jps2000/Horselite/README.md

# Horselite
3D printed spirometer for horses to be used with Datex Capnomac
For scientific purposes only.
