jps2000/Horselite/HorseLite 3D.pdf

### Horse_

©Vetme

Abstract

The sens
sensor. T
for horse

Pictures

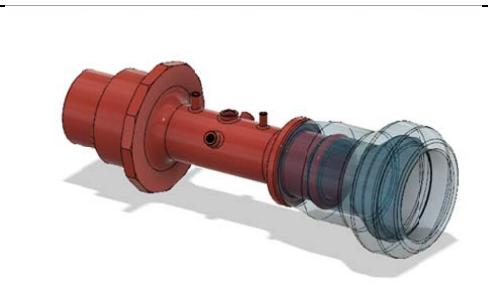
[picture p1: figure]

Descript

T
w

Referenc

MOENS
Proceed

MOENS
Pitot‐bas
anaesthe

MOENS
equine a

PICHLBA
Vienna.

### _lite 3D fo

eduni Vienna

sor is intende
The latter is
es. The senso

:

tion:

File: H_Lite3

Technology:
without supp

Material: PA

Instructions:

ces:

YPS, GOOTJE
ings of the 5

YPS, GOOTJE
sed flow met
esia. Veterin

YPS. 2010. C
anaesthesia.

UER B. 2019

### or Datex C

a, all rights re

ed to provid
intended for
or can be ea

3D.stl

SLS, SLA. It i
port structur

A2200 etc. se

: see Instruc

ES P, LAGERW
5th Internatio

ES P, IONITA
ter for the m
nary Anaesth

Clinical Applic
Equine Vete

. Validierun

### Capnomac

eserved Em

e spirometry
r human adu
sily inserted

is important
res

ee www.rapi

ction Horselit

WEIJ E. 1994
onal Congres

JC, HEINON
measurement
esia and Ana

cation of con
erinary Educa

ng des Spirom

### c / S5 mo

mail: johanne

y for horses.
ult use, has 1
between th

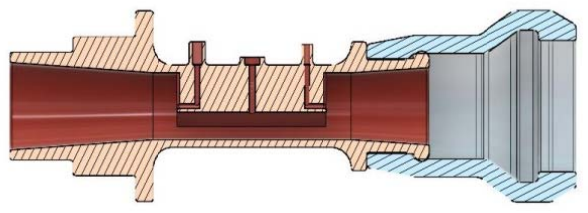
[picture p2: figure]

to have a sm

idobject.com

te 3D V1_0.d

. An introdu
ss of Veterin

EN E, SCHAT
t of respirato
algesia, 36: 2

ntinuous spir
ation, 22: 35

metrie‐Senso

### nitors

s.schramel@

It is a pitot t
5mm diame
e ETT and th

mooth surfac

or others. S

docx

ction to side
ary Anaesth

TZMANN U. 2
ory volume a
209 219.

rometry with
4 360.

ors Horse‐Lit

@vetmeduni.

tube based s
ter and henc
he Y‐ piece of

ce. The techn

Surface seali

e stream spir
esia, Guelph

2009. In vitro
and flow in la

h a pitot‐base

e 3D. Diplom

ac.at

sensor like th
ce can not be
f the circle sy

nology shoul

ing is recomm

rometry in th
h, Canada, pp

o validation o
arge animal

ed flow met

marbeit Vetm

he D‐Lite
e used
ystem.

d work

mended.

he horse.
p. 137.

of a

er during

meduni
