jps2000/Horselite/H_Lite1.png

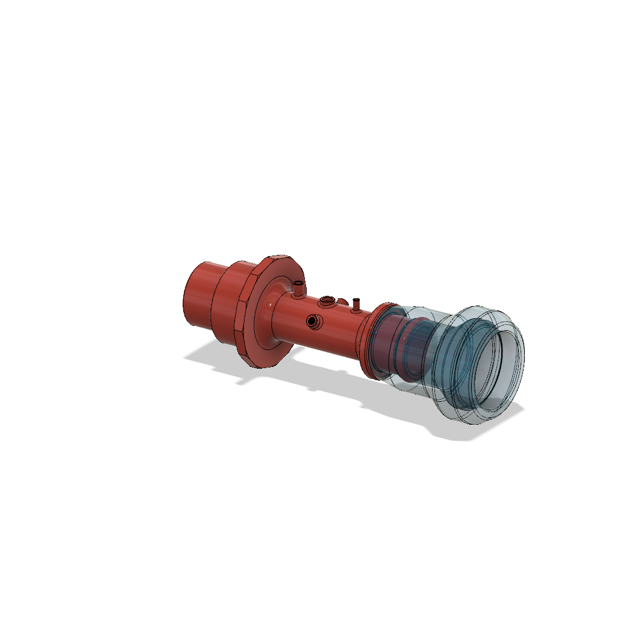
H_Lite1.png
