jps2000/Horselite/H_lite2.jpg

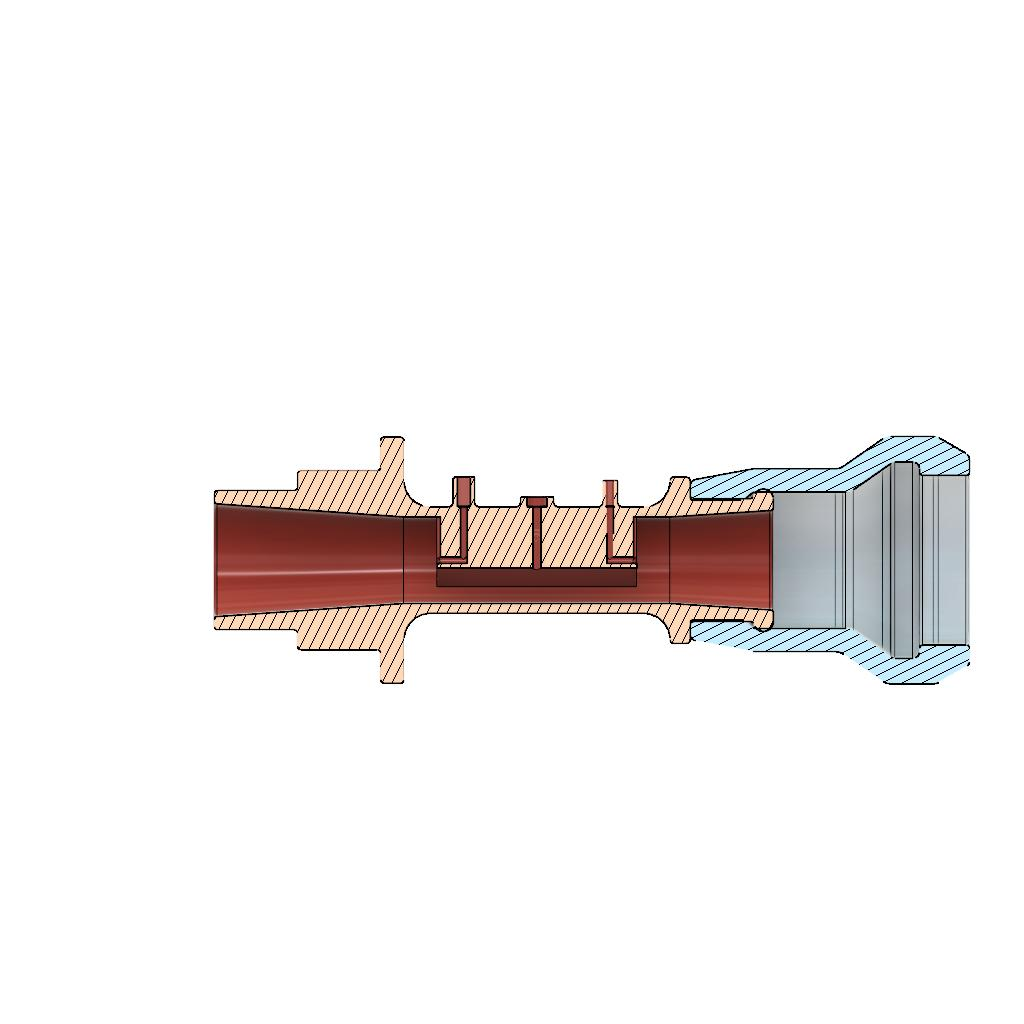
H_lite2.jpg
