jps2000/Horselite/H_Lite3D.stl

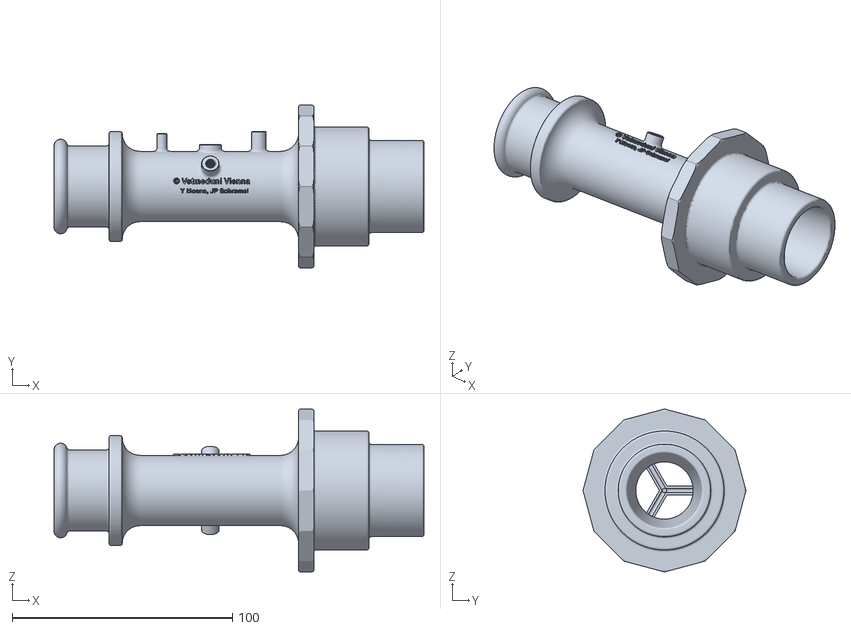
[picture p5: CAD file, 2021-03-08]
H_Lite3D.stl
168.0 x 74.0 x 74.0
